leoole100/anemometer/docs/architecture.md

# Architecture overview — updated 2026-07-04

High-level signal flow, power rails, mechanical boundaries, and de-risking strategy for the **Balanced Masthead Wind Station (No GPS)**.

```
                  WIND (40 kHz pulses)
                           │
                           ▼
              ┌─────────────────────────┐
              │    Waterproof Transducers│
              └────────────┬────────────┘
                           │
       TX: 12 Vpp pulses   │   RX: echo (~10 mV)
      (IXDF602 → DG412)    │   (74HC4051 → TLV9062 → PCM1808)
                           ▼
              ┌─────────────────────────┐
              │   Analog Front End      │
              └────────────┬────────────┘
                           │ I2S (96 kSPS, DMA)
                           ▼
              ┌─────────────────────────┐
              │      ESP32-S3           │
              │  (Motion & Heading Comp)│
              └───────┬─────────┬───────┘
                      │ I2C     │ WiFi (Signal K / NMEA)
                      ▼         ▼
             IMU / Mag Sensors  Boat Network (Cabin GPS / Display)
```

---

## Core System Architecture

The anemometer is split into a **Masthead Unit (Top Unit)** and a **Cabin/Deck Network (Bottom Unit)** to optimize cost, reliability, and installation complexity:

1.  **Masthead Unit (Top Unit):**
    *   Dedicated purely to ultrasonic time-of-flight wind speed and direction tracking.
    *   Includes an **IMU (ISM330DHCX)** for active mast-motion compensation and a **Magnetometer (MMC5983MA)** for automatic heading orientation.
    *   Does **not** contain a GPS module (the GPS receiver is located in the cabin/deck network where satellite lock is easier to maintain and cabling/servicing is simple).
    *   Communicates wirelessly over WiFi (Signal K / NMEA raw UDP pings) to the boat's server.
    *   Encased in a simple 3D-printed enclosure and waterproofed directly by **brushing structural epoxy** over the electronics, eliminating the need for expensive watertight gaskets.
2.  **Cabin Unit / Boat Network (Bottom Unit):**
    *   Handles navigation displays, GPS coordinate tracking, and Signal K data multiplexing.

---

## Masthead Unit Power Structure

Power is supplied directly from the boat's $12\text{ V}$ house network via a simple 2-wire cable up the mast (no deck-side USB-C PD trigger box required).

*   **12 V Input:** Fed directly to the **IXDF602** gate driver and the **DG412** switch selector. This drives the active transducer with a strong **$12\text{ Vpp}$** square wave, completely eliminating the need for a high-voltage boost converter.
*   **3.3 V Digital buck (3.3D):** Generated by an **AP63203** buck regulator from the $12\text{ V}$ input. Powers the ESP32-S3, the SMT sensors (IMU, Magnetometer), and the digital core of the ADC.
*   **3.3 V Analog LDO (3.3VA):** Generated by a low-cost, high-voltage **HT7333-A** LDO regulator directly from the $12\text{ V}$ input to power the sensitive analog op-amps and the ADC's analog domain.
*   **LED Light Ring Buck:** An **AL8860** buck driver regulates $180\text{ mA}$ to a 1S6P parallel string of 6 Cree C503B LEDs (powered from the $12\text{ V}$ input).

---

## Masthead Unit Signal Chain

### Transmit (TX)
*   The ESP32-S3's LEDC peripheral generates a 40 kHz square wave on `PWM_A`.
*   The **IXDF602** dual gate driver buffers this signal, shifting it to a $12\text{ Vpp}$ output rail.
*   A **DG412** quad SPST switch selects the active transmitting transducer (`TX_SEL0-3` controlled directly by ESP32 GPIOs).
*   During transmission, the inactive channels are held Hi-Z by opening their respective DG412 switches ($C_{off} \approx 5\text{ pF}$, $R_{off} \approx \text{Gigaohms}$).

### Receive (RX)
*   The small acoustic echo received by the transducer is routed via a $10\text{ k}\Omega$ resistor and a BAV99 clamp diode (to protect the inputs) to a **74HC4051** 8-channel analog multiplexer.
*   The active channel's signal is routed through the multiplexer to a **single TLV9062** dual op-amp chip:
    *   **Stage 1 (A1):** Fixed-gain bandpass amplifier providing $+40\text{ dB}$ (G=100) gain.
    *   **Stage 2 (A2):** $48\text{ kHz}$ Sallen-Key low-pass filter to act as an anti-aliasing filter.
*   The filtered signal is AC-coupled to a **PCM1808** stereo I2S ADC.
*   The PCM1808 samples the waveform continuously at **$96\text{ kSPS}$** (2.4 samples per carrier cycle) and streams the 24-bit data directly into the ESP32-S3's RAM using standard I2S DMA.

---

## De-risking Rules

1.  **Direct SMT Mounting:** The IMU and Magnetometer are soldered directly to the main PCB to save cost and space.
2.  **Thermal Peninsula:** The SHT41 temperature sensor is completely omitted to avoid self-heating issues.
3.  **Brush-On Waterproofing:** Brush structural epoxy over the electronics (using Kapton tape to mask the sensor ports of the IMU and Magnetometer, and the ESP32 WiFi antenna). This eliminates the cost and complexity of watertight enclosure seals.
4.  **No PGA / Fixed Gain:** A fixed gain of $+40\text{ dB}$ combined with the 24-bit ADC's high dynamic range ($>98\text{ dB}$ SNR) simplifies the AFE, eliminating the PGA and gain switches.
