leoole100/anemometer/(commit log)

2026-07-03 Initial architecture and acoustic chain design docs
2026-07-03 Resolve verify list: per-transducer DRV8876, parallel ADC via LCD_CAM, part selections
2026-07-03 GPIO map, remaining part selection, KiCad project skeleton
    [anemometer.kicad_sch]
2026-07-03 Add KiCad MCP server config, schematic generator experiments
    MCP server (mixelpixx/KiCAD-MCP-Server v2.3.0) installed at ~/tools/KiCAD-MCP-Server,
    built and smoke-tested: 178 tools incl. schematic capture, ERC, JLCPCB, freerouting.
    tools/schgen.py kept as reference: netlist-verified generation works; ERC
    label_dangling false-positive mystery unresolved.
    [afe_demo.kicad_sch]
2026-07-04 AFE fully valued; TX marker moved to logic-side injection
    - New docs/afe-design.md: complete component/value spec for the analog
    chain (RX gain stages, DRV8876 wiring, TPS61170 boost feedback network,
    AD9235 single-ended config, 74AHC595 control map).
    - TX marker redesign: power-side divider rejected (couples TX ring-down
    at 5-60x echo level); marker now injected from PWM_A via 3.3M.
    - Resolve all acoustic-design open items; update pinmap (GPIO3 = SR /OE).
    - Replace hardware/ skeleton with electronics/ KiCad project; ignore
    KiCad lock/autosave files.
    [afe_demo.kicad_sch, anemometer.kicad_sch, electronics.kicad_pcb, electronics.kicad_sch]
2026-07-04 Design review 2026-07-04: 4 findings fixed; power + digital designs added
    Review (docs/design-review-2026-07-04.md) re-derived every number in the
    existing docs. Findings, all fixed on paper:
    - F1: RX AC-coupling (10 nF/100 k) settled with tau ~1.1 ms, one full slot,
    after every mux channel switch -> PGA/A2 clipping risk at high gain.
    Changed to 1 nF (tau ~110 us) + firmware rule to pre-switch the mux.
    - F2: driver sleep duty-cycle savings were computed against a 6 ms sequence,
    but the frame is 96% busy -> claimed 20 mW was really ~0.58 W. nSLEEP is
    now per-driver (4 SR bits, bits existed), pings grouped per direction ->
    70-150 mW average.
    - F3: 6-series LED string can't buck from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
2026-07-04 Enclosure design notes; resolves GPS/LED placement open item
    Acoustic section (grommet mounting, strut placement at 45 deg to the axes,
    aluminum reflector insert, multipath check: shortest parasitic arrives
    >=230 us late vs the +-60 us search window), environment (ASA, Gore vent,
    conformal-coat boundaries, SHT41 labyrinth), and the GPS/LED top-disc
    arrangement under the diffuser dome.
    Claude-Session: https://claude.ai/code/session_011D21aKsbKyfRf7zaawgDTt
2026-07-04 Full BOM with costs; USB-C receptacle for development, glue-shut final seal
    docs/bom.md: refdes-level part selection for every subsystem with package
    choices and cost rollup: ~612 EUR all-in for the 5-assembled-boards
    strategy, ~160 EUR of that is the flying unit's own BOM. Key price facts
    from distributor checks: AD9235BRUZ-20 is ~30 EUR/pc (populate 3 of 5
    boards), transducers are cheap (3.60 EUR at qty 10), SAM-M10Q ~17 EUR.
    Farnell listing catch: MCUSD16A40S12RO sensitivity is -74 dB, not -65 dB
    as first researched -> echo ~1.3 mV worst case, 50 dB gain needed, inside
    the 70 dB authority; recorded in acoustic-design.md.
    USB-C decision (user): real 16-pin USB2 receptacle instead of a ba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
2026-07-04 Rework BOM for hand-assembled single unit; package audit (no BGA)
    Package audit: nothing is BGA. Leaded parts (iron), two exposed-pad parts
    (back-via or hot air), and a leadless minority (LGA sensors, DFN SHT41,
    WSON boost, LGA GPS) that needs stencil+reflow. Iron-only fallbacks
    documented (LMR64010 for the WSON boost, sensor breakouts) but the
    recommended path is a cheap hotplate/hot-air station and no design change.
    Cost rollup redone for self-assembly: ~275 EUR all-in (trimmed ~205),
    vs 612 EUR before -- the difference was the assembly service (140) and
    4x extra part sets, not the components; one electronics set is ~100 EUR.
    AD9235 plan: buy 2 (fitted + spare). README strategy and de-ris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
2026-07-04 doc: Update system architecture, BOM, and power design for Balanced Masthead Unit
    Updates system documentation to reflect:
    - Split system architecture: GPS and weather sensors moved to the cabin/bottom unit.
    - Wide-range power input (5-19 V) with 12V direct-drive (no boost converter).
    - Cree C503B 5 mm THT LEDs in 1S6P parallel configuration for potted light ring.
    - BOM optimization using user's spare transducers/epoxy and budget PCB fab (saving €64.60).
2026-07-04 doc: Refactor analog front-end, digital design, and GPIO pin mapping
    Updates documentation for the acoustic front-end and digital controllers:
    - Swapped to 74HC4051 RX multiplexer and TLV9062 op-amp for fixed gain AFE.
    - Integrated the PCM1808 24-bit 96 kHz stereo I2S ADC.
    - Swapped to BAT54S Schottky clamp diodes for V_INPUT protection (5-19 V range).
    - Consolidated digital controls to 17 active GPIOs on the ESP32-S3 (retaining 19 spares).
